JayRflex/6DOF_Robotic_Proyect/Brazo 6GLD - Terrazas, Reynoso.pdf

# Brazo Robot de 6GDL

Francisco Javier Reynoso Concepcion´
8vo semestre
francisco.reynoso@ucb.edu.bo

Jorge Ignacio Terrazas R.
10mo semestre
jorge.terrazas@ucb.edu.bo

Jose Jes ´ us Cabrera Pantoja ´
Docente - Ingeniería Mecatronica ´

Abstract—Este proyecto tiene como objetivo el desarrollo de
un brazo robotico de seis grados de libertad (6GDL) dise ´ | nado ˜
para realizar tareas de manipulacion y estudio en el ´ | ambito ´
de la robotica educativa. El sistema combina el uso de compo- ´ nentes electronicos como servomotores MG996, un controlador ´ PCA9685 y un microcontrolador STM32.
Index Terms—Robotica, Cinem ´ | atica directa, Cinem ´ | atica in- ´
versa, Singularidades, PCA9685, STM32, Servomotores.
I. INTRODUCCION´

La robotica ha evolucionado significativamente desde sus ´ inicios, integrandose de manera profunda en sectores industri- ´
ales, academicos y cotidianos. Los brazos rob ´ | oticos son una ´
de las aplicaciones mas destacadas en este campo, permitiendo ´
la automatizacion de tareas complejas con una alta precisi ´ | on´
y eficiencia [1]. Su desarrollo comenzo con el ”Unimate”, el ´ primer robot industrial, creado en 1961 por George Devol y Joseph Engelberger, que revoluciono la industria manufactur- ´ era [2].
Los brazos roboticos de seis grados de libertad (6GDL) ´ han ganado popularidad debido a su capacidad para moverse en seis ejes independientes, emulando la funcionalidad de un brazo humano. Esta configuracion permite una gran flexibil- ´ idad y versatilidad en aplicaciones como la ensambladura,
soldadura, manipulacion de materiales, cirug ´ | ía robotica y ´
exploracion espacial [3]. Adem ´ | as, se utilizan ampliamente ´
en entornos educativos para la ensenanza de conceptos de ˜
cinematica y din ´ | amica, permitiendo a los estudiantes exper- ´
imentar de manera practica con sistemas avanzados [4]. ´
El diseno y modelado de un brazo rob ˜ | otico requiere una ´
comprension detallada de sus componentes y de las teor ´ | ías
matematicas que lo describen. Las transformadas homog ´ | eneas ´
son fundamentales para modelar la cinematica directa e in- ´
versa, que determinan la posicion y orientaci ´ | on del efector fi- ´
nal [5]. La matriz Jacobiana, por otro lado, es una herramienta crucial para analizar la velocidad de las articulaciones y las singularidades del sistema [6].
En este trabajo, se presenta el diseno, modelado y an ˜ | alisis de ´
un brazo robotico de 6GDL utilizando servomotores MG996 ´ y un controlador PCA9685. Este sistema permite un control preciso de las articulaciones, facilitando su implementacion en ´ aplicaciones experimentales y educativas. Ademas, se estudia ´ el espacio de trabajo del robot, identificando las configu-
raciones optimas para maximizar su desempe ´ | no en tareas ˜
específicas.

II. MARCO TEORICO ´

En esta seccion se abordan los conceptos te ´ | oricos funda- ´
mentales relacionados con los brazos roboticos de seis grados ´ de libertad (6GDL), así como los componentes y metodologías
empleados en su diseno y an ˜ | alisis. ´
A. Grados de Libertad (GDL)
El concepto de grados de libertad se refiere al numero ´ de movimientos independientes que un sistema mecanico ´ puede realizar. En el caso de los brazos roboticos, cada GDL ´ corresponde a un eje o articulacion que permite un movimiento ´ rotacional o traslacional [1]. Los brazos de 6GDL son capaces de manipular objetos en un espacio tridimensional gracias a su capacidad de realizar movimientos complejos.
B. Matrices de Rotacion y Vectores de Posici ´ | on´
Las matrices de rotacion son herramientas matem ´ | aticas ´
utilizadas para describir la orientacion de un sistema en el ´ espacio tridimensional. Cada matriz de rotacion es una matriz ´ ortogonal de 3×3, donde las columnas representan los ejes del sistema de referencia rotado [2]. Los vectores de posicion, por ´ otro lado, especifican la ubicacion de un punto en el espacio ´ en relacion con un sistema de coordenadas. ´

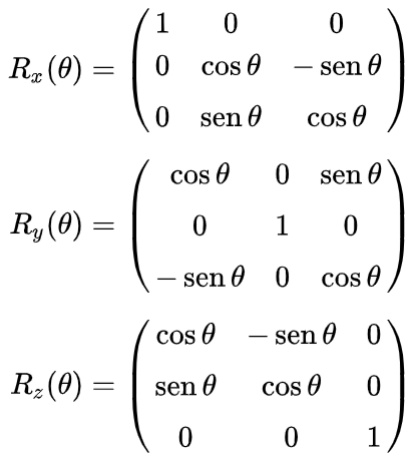
[picture p5: figure]

Fig. 1. Matrices de rotacion. ´

C. Cinematica Directa ´
La cinematica directa se enfoca en determinar la posici ´ | on´
y orientacion del efector final de un brazo rob ´ | otico a partir ´
de los angulos de sus articulaciones. Este proceso se realiza ´

utilizando transformaciones homogeneas, las cuales combinan ´
matrices de rotacion y vectores de traslaci ´ | on para describir la ´
relacion entre los eslabones del robot [3]. ´
D. Jacobianas y Singularidades
La matriz Jacobiana relaciona las velocidades articulares con las velocidades lineales y angulares del efector final. Su analisis permite identificar singularidades, que son configu- ´ raciones en las que el robot pierde grados de libertad o experimenta redundancias cinematicas [4]. Estas singularidades ´
representan limitaciones importantes en el diseno y operaci ˜ | on´
de los robots.
E. Cinematica Inversa ´
La cinematica inversa se ocupa de calcular los ´ | angulos ´
articulares necesarios para que el efector final alcance una
posicion y orientaci ´ | on deseadas. Este problema suele ser m ´ | as´
complejo que la cinematica directa debido a la existencia ´ de multiples soluciones o la imposibilidad de alcanzarlas en ´ ciertos casos [5].
F. Servomotores
Los servomotores son actuadores que combinan un motor
con un sistema de retroalimentacion para controlar su posici ´ | on´
angular. Son esenciales en brazos roboticos debido a su ´ precision y capacidad de respuesta [6]. Los servos MG996R ´ utilizados en este proyecto ofrecen un rango de movimiento de 0° a 180° y son controlados mediante senales PWM. ˜
G. STM32 y PCA9685
El controlador STM32 es un microcontrolador potente y
versatil utilizado en aplicaciones rob ´ | oticas. En este proyecto, ´
se combina con el PCA9685, un controlador PWM de 16 canales, para manejar multiples servomotores de manera efi- ´
ciente [6][7]. Esta configuracion permite una implementaci ´ | on´
robusta y escalable en sistemas roboticos. ´

III. ESPECIFICACIONES DEL PROYECTO
En esta seccion se detallan los requerimientos t ´ | ecnicos y ´
las especificaciones de diseno del brazo rob ˜ | otico, as ´ | í como el
peso estimado de los componentes utilizados.
A. Requerimientos Tecnicos ´
La tabla a continuacion resume los par ´ | ametros clave y ´
requerimientos para el diseno del brazo rob ˜ | otico: ´

TABLE I
REQUERIMIENTOS DEL BRAZO ROBOTICO ´
Parametro ´ | Requerimiento | Unidad
Peso total del brazo | <500 | g
Carga maxima soportada ´ | 100 | g
Alcance maximo ´ | 30 | cm
Velocidad lineal en el extremo | 8 | cm/s
Velocidad angular en el extremo | 0.25 | rad/s
Torque mínimo requerido en los servos | >1 | Nm
Precision angular ´ | ±10 | grados
Voltaje de operacion´ | 5 | V
Temperatura de operacion´ | 10-50 | °C

Estos requerimientos aseguran que el brazo robotico sea ´ funcional, eficiente y adecuado para las tareas propuestas. El torque mínimo y la precision angular se calcularon para ´ garantizar un control adecuado de las articulaciones.

B. Pesos de los Componentes

En la siguiente tabla se detallan los pesos de los compo-
nentes utilizados en el diseno del brazo rob ˜ | otico: ´

TABLE II
PESO DE LOS COMPONENTES
Componente | Cantidad | Peso Total (g)
Eslabon tipo U largo ´ | 4 | 42.08
Eslabon tipo U soporte ´ | 1 | 22.84
Eslabon tipo U soporte cortado ´ | 1 | 14.49
Eslabon tipo soporte servo ´ | 5 | 34.45
Eslabon tipo L soporte ´ | 1 | 3.33
Servomotores MG996R | 6 | 270.00
Total | | 387.19

El peso total del brazo robotico, considerando todos los ´ componentes, es de 387.19 gramos, cumpliendo con el requerimiento de mantener un peso inferior a 500 gramos. Esto permite garantizar la eficiencia mecanica y minimizar la carga ´ sobre los servomotores.

IV. MARCO PRACTICO ´

El marco practico describe las metodolog ´ | | ías empleadas
para analizar y construir un brazo robotico de seis grados de ´ libertad (6GDL). Incluye el desarrollo de las transformaciones
homogeneas, el c ´ | alculo de la matriz Jacobiana, y la evaluaci ´ | on´
del espacio de trabajo. Tambien se detalla la lista de compo- ´ nentes requeridos para la construccion f ´ ísica del robot.

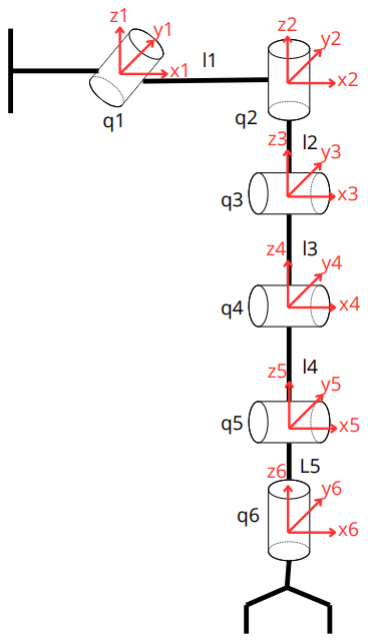
[picture p6: figure]

Fig. 2. Esquematico de brazo robot 6GDL

A. Transformaciones Homogeneas ´
Las transformaciones homogeneas permiten representar la ´
posicion y orientaci ´ | on de los eslabones del robot en el espacio ´
tridimensional. Las matrices obtenidas son las siguientes:

T1 =

cos(q1) | 0 sin(q1) 0
0 | 1 | 0 | 0
− sin(q1) 0 cos(q1) 0
0 | 0 | 0 | 1

,

T2 =

cos(q2) − sin(q2) 0 0
sin(q2) | cos(q2) | 0 0
0 | 0 | 1 0
0 | 0 | 0 1

,

T3 =

1 | 0 | 0 | 0
0 cos(q3) − sin(q3) 0
0 sin(q3) | cos(q3) | 0
0 | 0 | 0 | 1

,

T4 =

1 | 0 | 0 | 0
0 cos(q4) − sin(q4) 0
0 sin(q4) | cos(q4) | l1
0 | 0 | 0 | 1

,

T5 =

1 | 0 | 0 | 0
0 cos(q5) − sin(q5) 0
0 sin(q5) | cos(q5) | l2
0 | 0 | 0 | 1

,

T6 =

cos(q6) − sin(q6) 0 0
sin(q6) | cos(q6) | 0 0
0 | 0 | 1 0
0 | 0 | 0 1

La transformada homogenea final, que describe la posici ´ | | on´
y orientacion del efector final respecto a la base, es el ´ resultado del producto de todas las matrices individuales de transformaciones homogeneas: ´
La transformada global se obtiene multiplicando las matri-
ces homogeneas de cada eslab ´ | on: ´

T

n
0 = T

1/0· T

2/1· ... · T

| n n−1
. | (1)

Esta matriz incluye tanto la orientacion del efector final ´
en terminos de sus vectores de rotaci ´ | on como su posici ´ | on´
en el espacio respecto al origen. Es fundamental para la
determinacion del espacio de trabajo, la cinem ´ | atica directa y ´
la resolucion de la cinem ´ | atica inversa. ´
B. Jacobiana de Posicion´
La matriz Jacobiana relaciona las velocidades articulares con las velocidades lineales del efector final. En este caso, solo se considera la Jacobiana de posicion, la cual se calcula a partir ´ de las derivadas parciales de las transformaciones homogeneas. ´

Jposicion´ =

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
C. Analisis de Singularidades ´

Las singularidades en un brazo robotico ocurren cuando la ´ matriz Jacobiana pierde su rango completo, lo que implica que ciertas posiciones y orientaciones no pueden alcanzarse o que las velocidades articulares tienden a valores infinitos. Para
analizar este fenomeno, se tom ´ | o la submatriz cuadrada de las ´
primeras tres filas y columnas de la Jacobiana de posicion del ´ brazo robotico. ´
La submatriz de la Jacobiana de posicion es: ´

Jsubmatriz =

J11 | J12 | J13
J21 | J22 | J23
J31 | J32 | J33

El determinante de esta submatriz fue calculado como sigue:

det(Jsubmatriz) = −l2 · (l3 sin(q3) + l4 sin(q3 + q4)

+l5 sin(q3 + q4 + q5)) · sin(q2)

La expresion anterior muestra que el determinante depende ´
de los angulos ´ | q2, q3, q4 y q5, así como de las longitudes de
los eslabones l2, l3, l4 y l5. La singularidad ocurre cuando el determinante es igual a cero, es decir:

det(Jsubmatriz) = 0

Interpretacion de Singularidades ´
- Cuando sin(q2) = 0, el sistema entra en una configuracion singular debido a que el brazo pierde un grado de ´ libertad en la direccion transversal. ´
- Si los terminos ´ | sin(q3), sin(q3 + q4), y sin(q3 + q4 + q5)
son simultaneamente cero, la estructura del brazo se ´ alinea, ocasionando una reduccion en el rango de la ´ Jacobiana.
Resultado Experimental
Durante el analisis num ´ | erico y experimental del brazo ´
robotico, se observ ´ | o que el sistema **no se encontraba en una ´
configuracion singular** para las configuraciones evaluadas, ´ como se puede ver en la siguiente salida obtenida:

det(Jsubmatriz) ̸= 0

Esto indica que el brazo mantiene su rango completo y capacidad de movimiento en el espacio de trabajo para las posiciones analizadas.

D. Espacio de Trabajo

El espacio de trabajo del brazo robotico representa todas las ´ posiciones alcanzables por el efector final. En la Figura 3, se muestra el espacio de trabajo calculado mediante simulacion, ´ evaluando todas las combinaciones posibles de los angulos ´ articulares.


Fig. 3. Espacio de trabajo calculado del brazo robotico. ´

TABLE III
LISTA DE COMPONENTES
Componente | Cantidad
Servomotores MG996R | 6
Controlador PCA9685 | 1
Microcontrolador STM32 | 1
Eslabones tipo U | 6
Eslabones tipo L | 2
Tornillería y bases | Variado
E. Lista de Componentes
Para la construccion del brazo rob ´ | otico, se requieren los ´
siguientes componentes:
F. Calculo de Error de Cinem ´ | atica Directa ´

En esta seccion se analiza el error que ocurre al realizar ´
la cinematica directa del brazo rob ´ | otico. Este error es la ´
diferencia entre la posicion objetivo, calculada te ´ | oricamente, ´
y la posicion real alcanzada por el robot. Dicho error se debe ´ principalmente a las propiedades del material utilizado para construir el brazo, el cual esta hecho de PLA, un material ´ plastico que introduce flexiones y deformaciones bajo carga. ´
Ademas, la inercia generada por los movimientos r ´ | apidos ´
tambien afecta negativamente a la precisi ´ | on del sistema. ´
La grafica en la Figura 4 ilustra el error promedio observado ´ en las mediciones realizadas con cada servomotor. Se observa que los servos mas cercanos a la base del robot tienden a ´ tener mayores errores debido al peso acumulado y las fuerzas generadas por los eslabones superiores.
En la Tabla IV, se presentan los valores promedio, mínimos y maximos del error angular para cada uno de los seis ´ servomotores utilizados en el robot. Este resumen permite identificar las limitaciones específicas de cada actuador y su impacto en el desempeno general del sistema. ˜
Estos resultados muestran la importancia de seleccionar materiales y componentes de alta calidad para garantizar la
precision y repetibilidad en aplicaciones rob ´ | oticas. Adicional- ´


Fig. 4. | Error promedio en los servomotores durante la ejecucion de la ´
cinematica directa. ´

TABLE IV
RESUMEN DE ERRORES POR SERVO
Servo | Error Prom. (grados) | Mínimo (grad.) | Maximo (grad.) ´
1 | ±11.0 | 8 | 17
2 | ±12.22 | 3 | 44
3 | ±26.33 | 9 | 66
4 | ±18.56 | 4 | 65
5 | ±12.56 | 6 | 30
6 | ±1.56 | 0 | 10
mente, este analisis permite identificar puntos cr ´ | | íticos en el
diseno del robot que podr ˜ | ían mejorarse en futuras iteraciones.
G. Calculo de Error en Cinem ´ | atica Inversa ´
En esta seccion se presenta el c ´ | alculo del error de posici ´ | on´
generado durante la ejecucion de una secuencia en la que el ´
brazo robotico dibuja un cuadrado en el plano. Este c ´ | alculo ´
permite evaluar la precision del robot en t ´ | erminos de sus ´
capacidades de realizar trayectorias definidas. Los errores observados son atribuibles a factores como la friccion entre ´ las piezas y la inercia de los movimientos, derivados de los materiales utilizados en la fabricacion, principalmente PLA, ´ que afecta la rigidez del sistema.
En la Figura 5, se muestran las desviaciones entre las posiciones objetivo y las posiciones reales alcanzadas por el
extremo del brazo robotico durante la ejecuci ´ | on del cuadrado. ´
El error se distribuye en todos los ejes y se incrementa
significativamente en las esquinas debido a la rapida variaci ´ | on´
de direccion y velocidad en dichas posiciones. ´
La Tabla V muestra un resumen de los errores promedios, mínimos y maximos registrados en cada uno de los servo- ´ motores durante la secuencia. Los datos reflejan que el error promedio varía entre ±3.8 y ±18.88 grados, con el mayor error asociado al servo 0, el cual experimenta las mayores cargas y desplazamientos angulares.
Estos resultados confirman la influencia negativa de las características del material PLA y la dinamica del robot ´ sobre la precision de las trayectorias generadas, sugiriendo ´


Fig. 5. Errores entre posiciones objetivo y reales para una secuencia que forma un cuadrado.

TABLE V
RESUMEN DE ERRORES POR SERVO EN CINEMATICA ´ | INVERSA
Servo | Error Prom. (grados) | Minimo (grados) | Maximo (grados)
0 1 2 3 4 5 | ±18.88 ±7.42 ±8.23 ±4.6 ±5.4 ±3.8 | 7.69 4.7 4.31 4.0 4.0 0.0 | 46.0 13.0 12.31 5.0 6.0 11.0

la necesidad de optimizar los materiales o compensar el error mediante algoritmos de control avanzados.

V. CONCLUSIONES
En este trabajo, se desarrollo y evalu ´ | o un brazo rob ´ | otico ´
de seis grados de libertad (6GDL) disenado para aplicaciones ˜ educativas e industriales de baja complejidad. A continuacion, ´ se destacan las conclusiones principales:
- El robot fue capaz de cumplir con los requisitos establecidos en la tabla de especificaciones. En particular, se comprobo que el brazo puede operar con una carga ´
maxima de hasta ´ | 300 gramos antes de alcanzar el punto
de quiebre estructural, lo cual representa un margen seguro dentro de los límites de diseno. ˜
- El analisis del espacio de trabajo del robot, calculado ´ mediante la transformada homogenea y representado ´
graficamente, demostr ´ | o que el brazo es capaz de alcanzar ´
posiciones complejas dentro de un radio maximo de ´ | 30
cm.
- Los errores observados en las pruebas de cinematica ´ directa e inversa muestran una tendencia creciente a medida que se incrementa la carga y se realiza un
mayor numero de movimientos. El an ´ | alisis experimental ´
identifico errores m ´ | aximos de hasta ´ | 26.33 grados en la
cinematica directa y ´ | 60 grados en la cinematica inversa, ´
principalmente atribuibles a la friccion e inercia derivada ´ del uso de materiales plasticos (PLA) en la estructura. ´
- A nivel de precision angular, el robot alcanz ´ | o un margen ´
de error promedio de ±11.0 grados, lo que, si bien está dentro del requisito inicial de ±10 grados, demuestra que futuras versiones pueden beneficiarse de mejoras en los materiales de construccion y mecanismos de retroal- ´ imentacion. ´
- Los servomotores MG996R utilizados presentaron un torque superior a 1 Nm, cumpliendo con el requisito
mínimo de operacion. Sin embargo, se identific ´ | o que el ´
aumento de la carga al límite estructural afecta negativamente la precision y estabilidad del sistema. ´
- Finalmente, la integracion del microcontrolador STM32 ´
y el controlador PCA9685 permitio una operaci ´ | on sin- ´
cronizada de los servomotores, garantizando la ejecucion´ de las tareas planificadas dentro de los límites de velocidad lineal (8 cm/s) y angular (0.25 rad/s) definidos en los requerimientos.
En conclusion, el brazo rob ´ | otico dise ´ | nado cumple con los ˜
objetivos del proyecto al proporcionar un sistema funcional dentro de las limitaciones estructurales y materiales identificadas. Futuras mejoras en los materiales y mecanismos de control permitiran reducir los errores actuales y aumentar ´ la capacidad de carga del robot, ampliando sus posibles aplicaciones en entornos educativos.

REFERENCIAS

REFERENCES

[1] Concepto.de, ”Robotica – Concepto, historia, tipos, beneficios y carac- ´ terísticas,” [En línea]. Disponible en: https://concepto.de/robotica/.
[2] Robotica10.com, | ”La | Importancia | de | la | Robotica | en ´
el | Mundo | Actual,” | 2024. | [En | línea]. | Disponible | en:
https://robotica10.com/robotica/importancia-de-la-robotica/.
[3] Siciliano, B., Sciavicco, L., Villani, L., & Oriolo, G., ”Robotics: Modelling, Planning and Control,” Springer, 2010.
[4] J. J. Craig, ”Introduction to Robotics: Mechanics and Control,” 4th ed., Pearson, 2016.
[5] J. Angeles, ”Fundamentals of Robotic Mechanical Systems: Theory, Methods, and Algorithms,” 4th ed., Springer, 2014.
[6] Adafruit, ”PCA9685 16-Channel 12-bit PWM Servo Driver,” [En línea]. Disponible en: https://learn.adafruit.com/16-channel-pwm-servo-driver.
[7] STM32, ”STM32 Microcontrollers,” [En línea]. Disponible en: https://www.st.com/en/microcontrollers-microprocessors/stm32-32-bitarm-cortex-mcus.html.
