JayRflex/6DOF_Robotic_Proyect/Eje de coordenadas.png

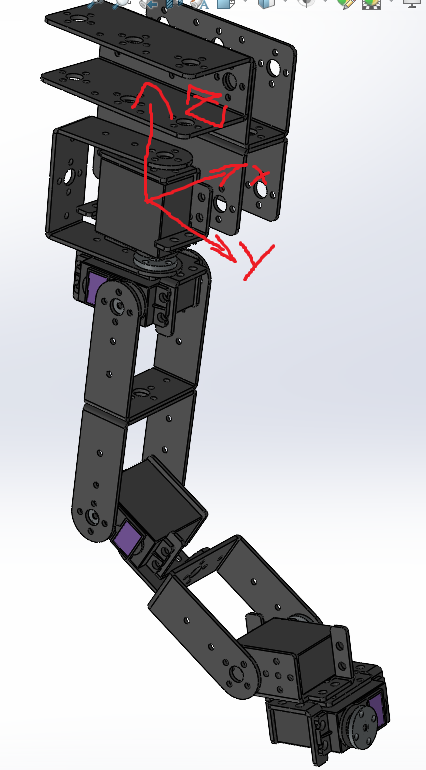
Eje de coordenadas.png
