JayRflex/6DOF_Robotic_Proyect/Planos Robot 6GDL.PDF

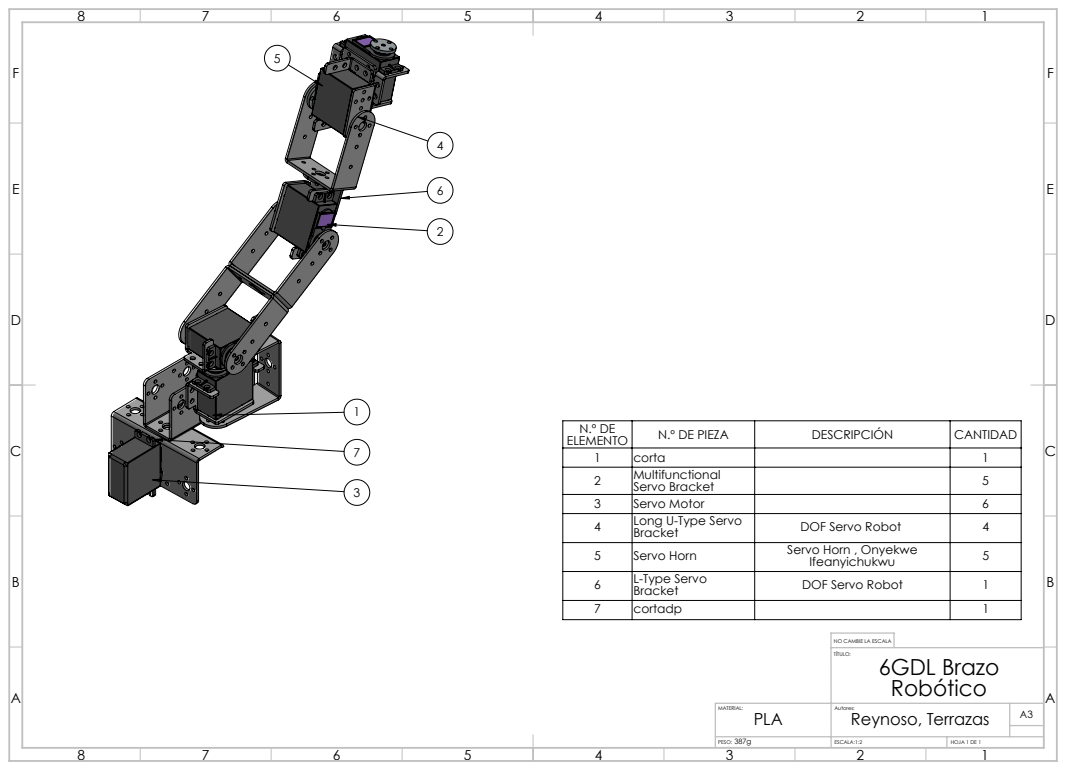
[picture p8: page 1]
ESCALA:1:2; HOJA 1 DE 1

N.º DE ELEMENTO | N.º DE PIEZA | DESCRIPCIÓN | CANTIDAD
1 | corta | | 1
2 | Multifunctional Servo Bracket | | 5
3 | Servo Motor | | 6
4 | Long U-Type Servo Bracket | DOF Servo Robot | 4
5 | Servo Horn | Servo Horn , Onyekwe Ifeanyichukwu | 5
6 | L-Type Servo Bracket | DOF Servo Robot | 1
7 | cortadp | | 1

NO CAMBIE LA ESCALA
TÍTULO:
6GDL Brazo
Robótico
Reynoso, Terrazas

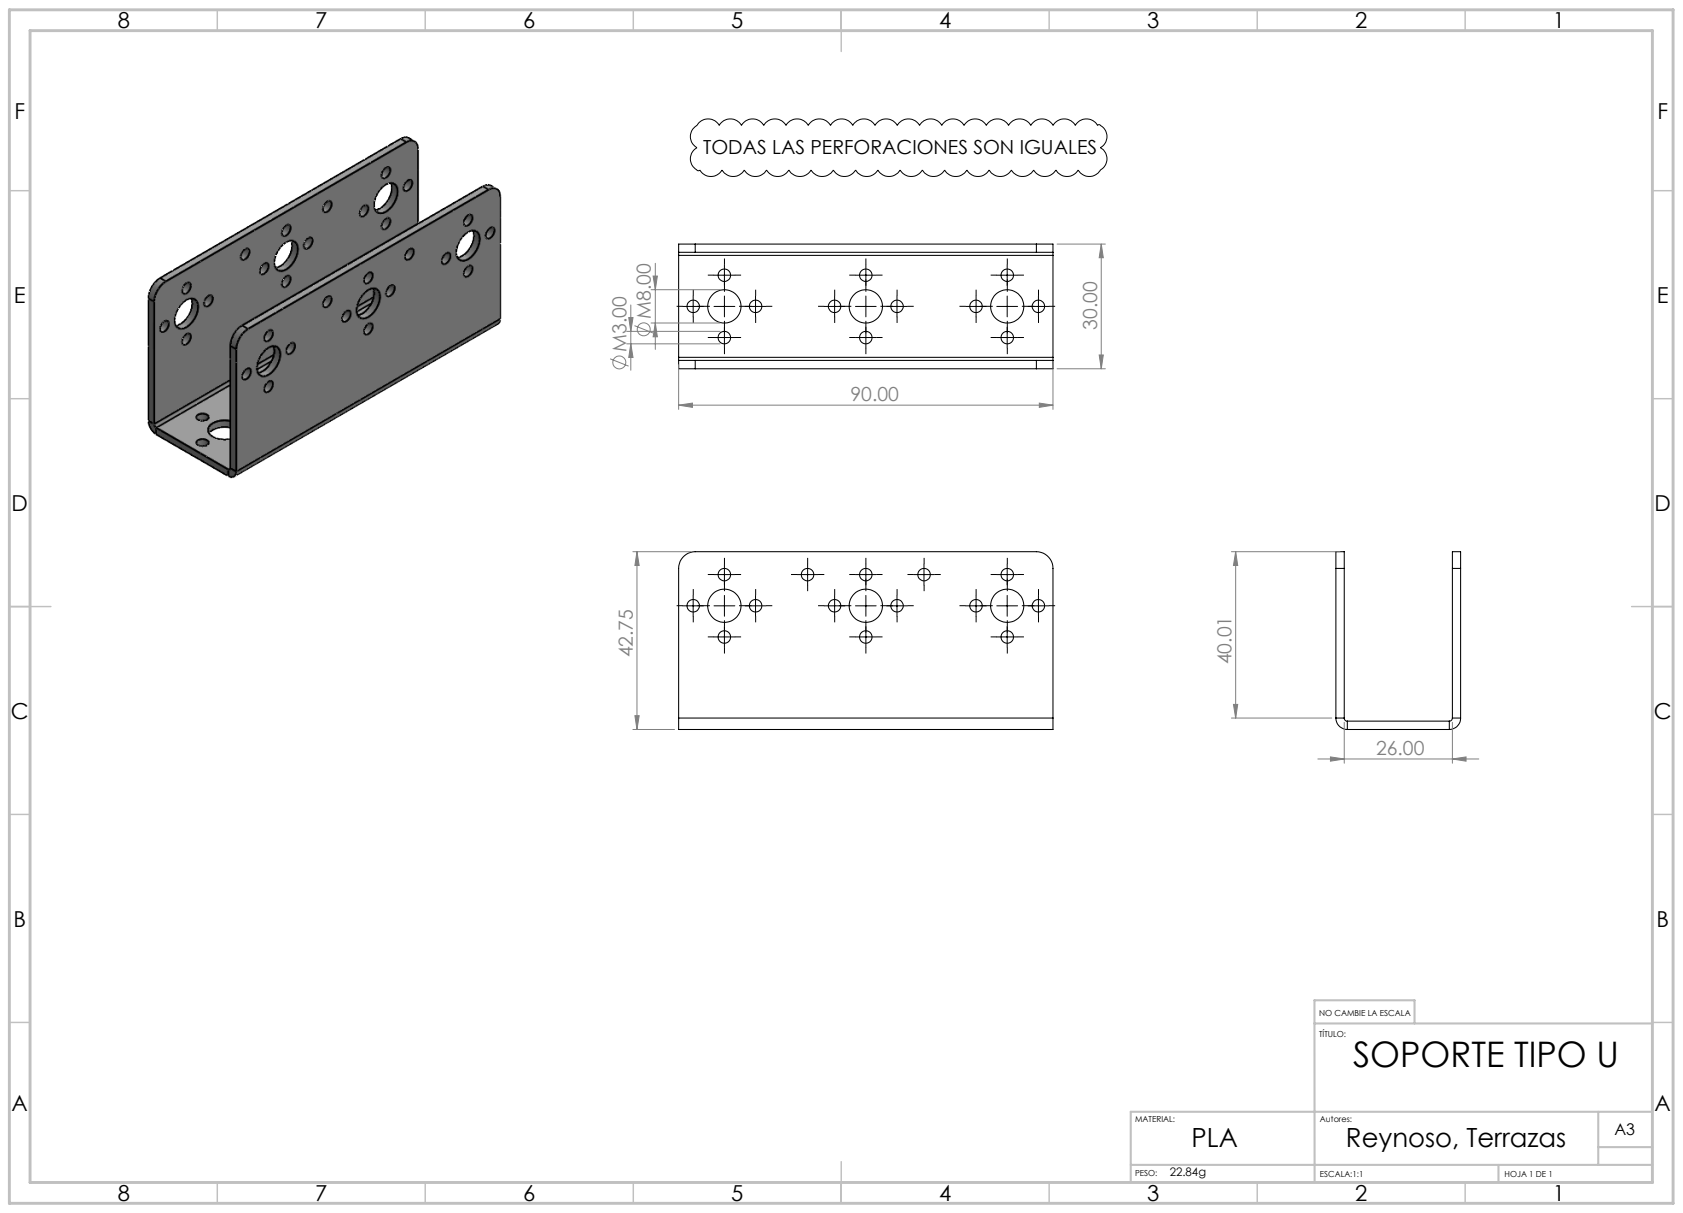
[picture p9: page 2]
ESCALA:1:1; HOJA 1 DE 1

TODAS LAS PERFORACIONES SON IGUALES

NO CAMBIE LA ESCALA
TÍTULO:
SOPORTE TIPO U

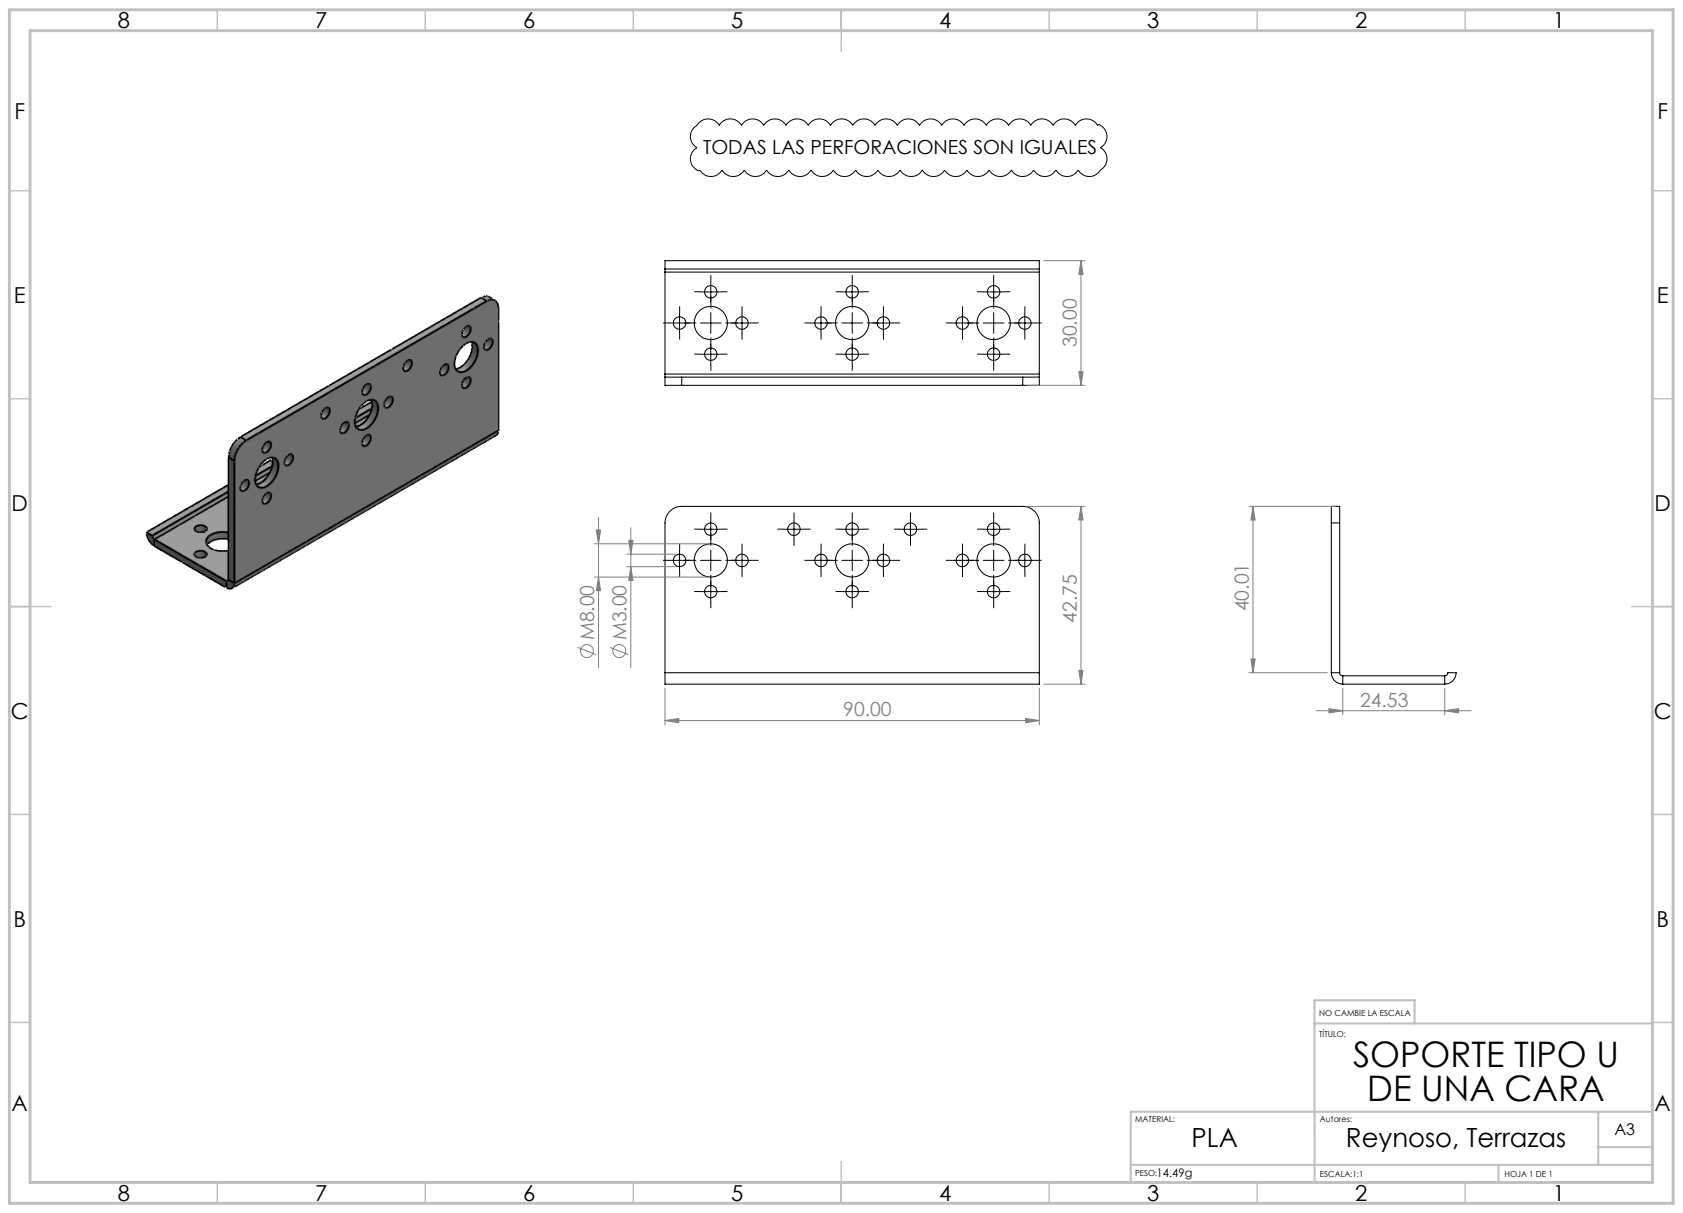
[picture p10: page 3]

TODAS LAS PERFORACIONES SON IGUALES

NO CAMBIE LA ESCALA
TÍTULO:
SOPORTE TIPO U
DE UNA CARA

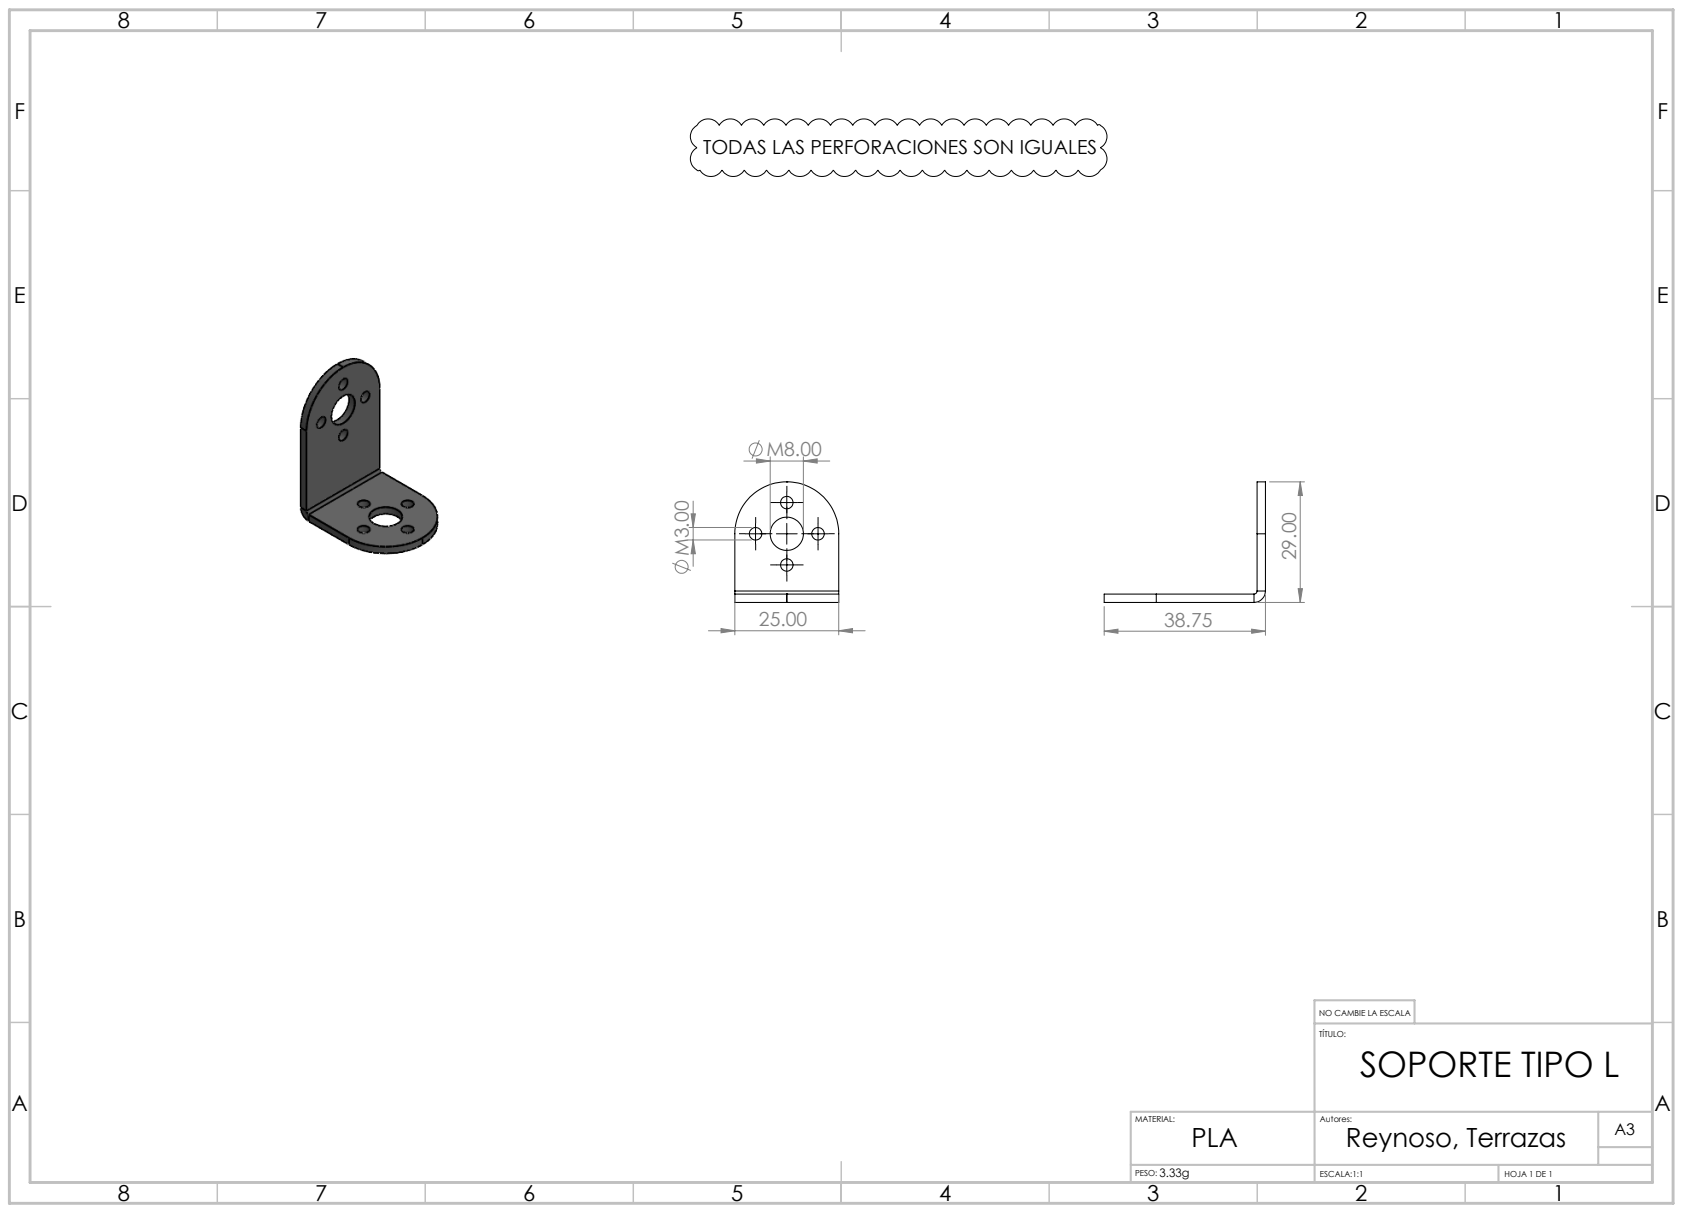
[picture p11: page 4]

TODAS LAS PERFORACIONES SON IGUALES

NO CAMBIE LA ESCALA
TÍTULO:
SOPORTE TIPO L

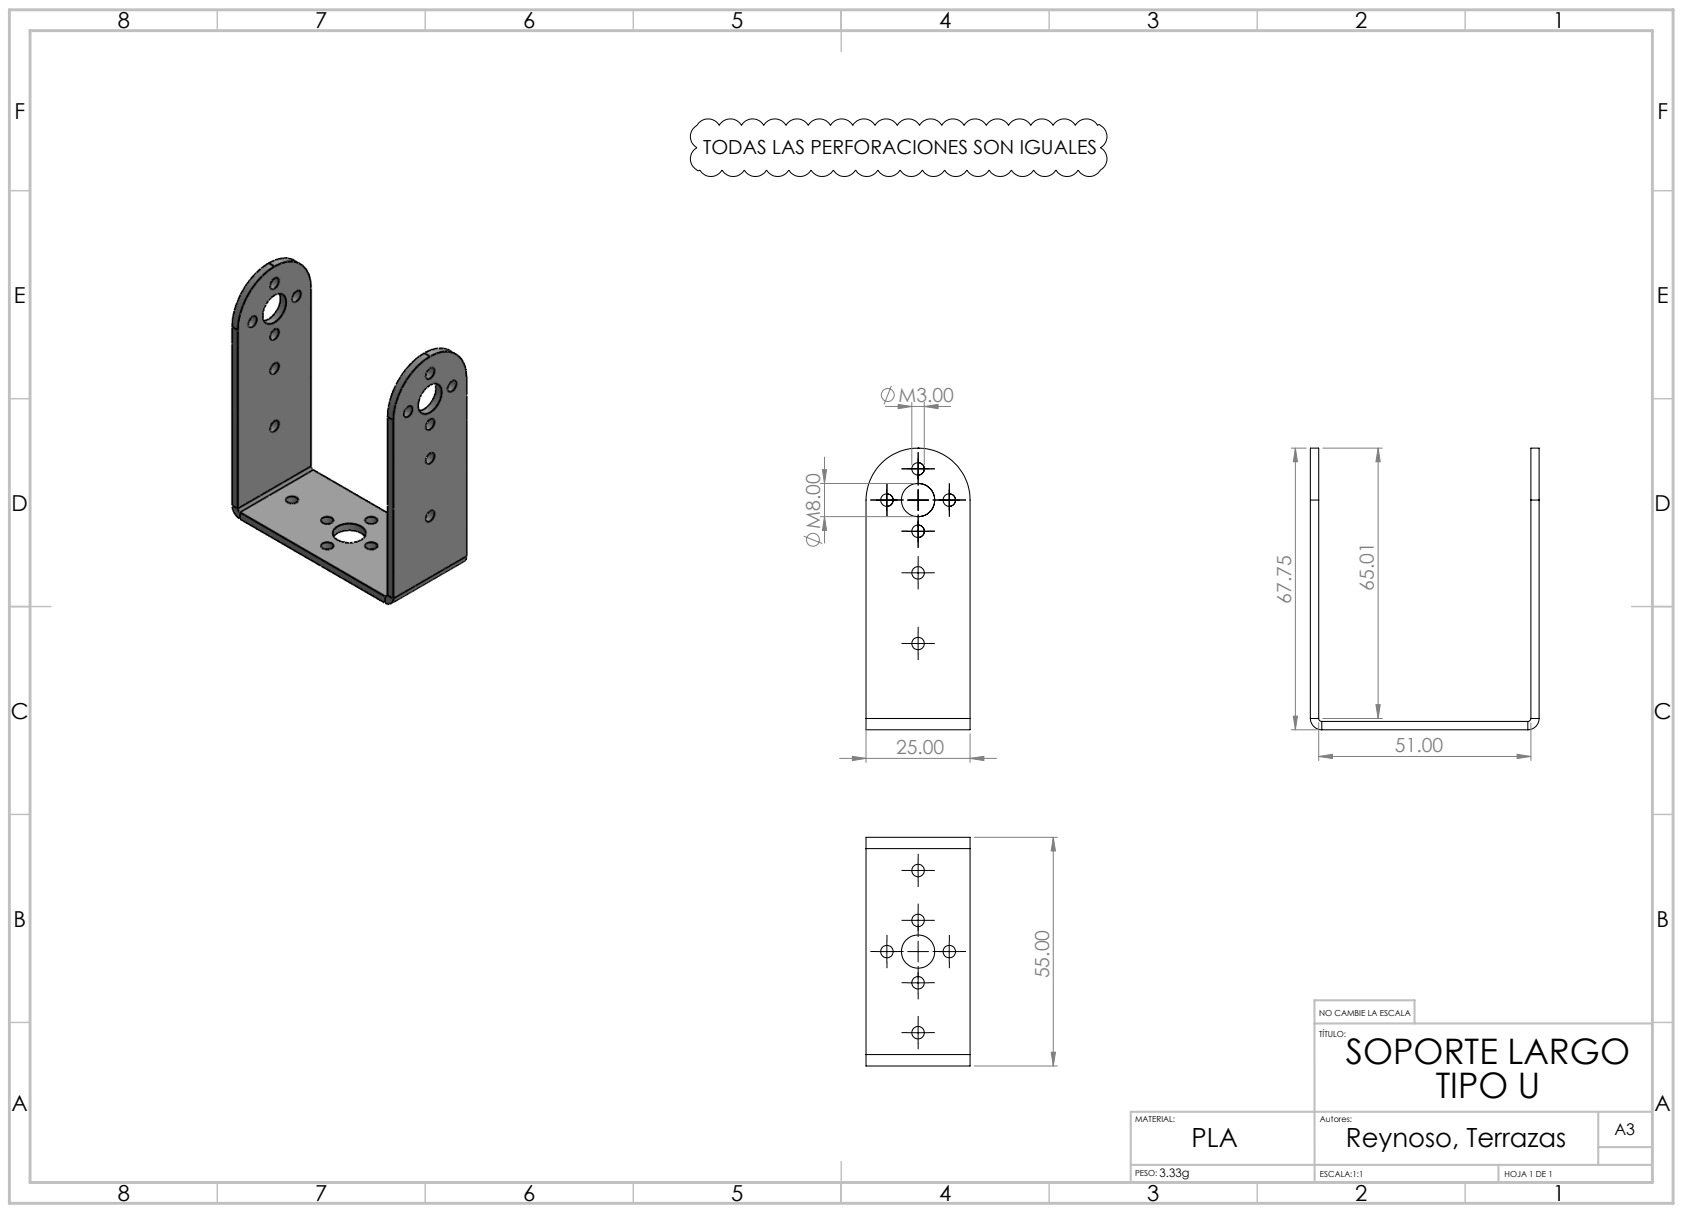
[picture p12: page 5]

TODAS LAS PERFORACIONES SON IGUALES

NO CAMBIE LA ESCALA
SOPORTE LARGO
TÍTULO:
TIPO U

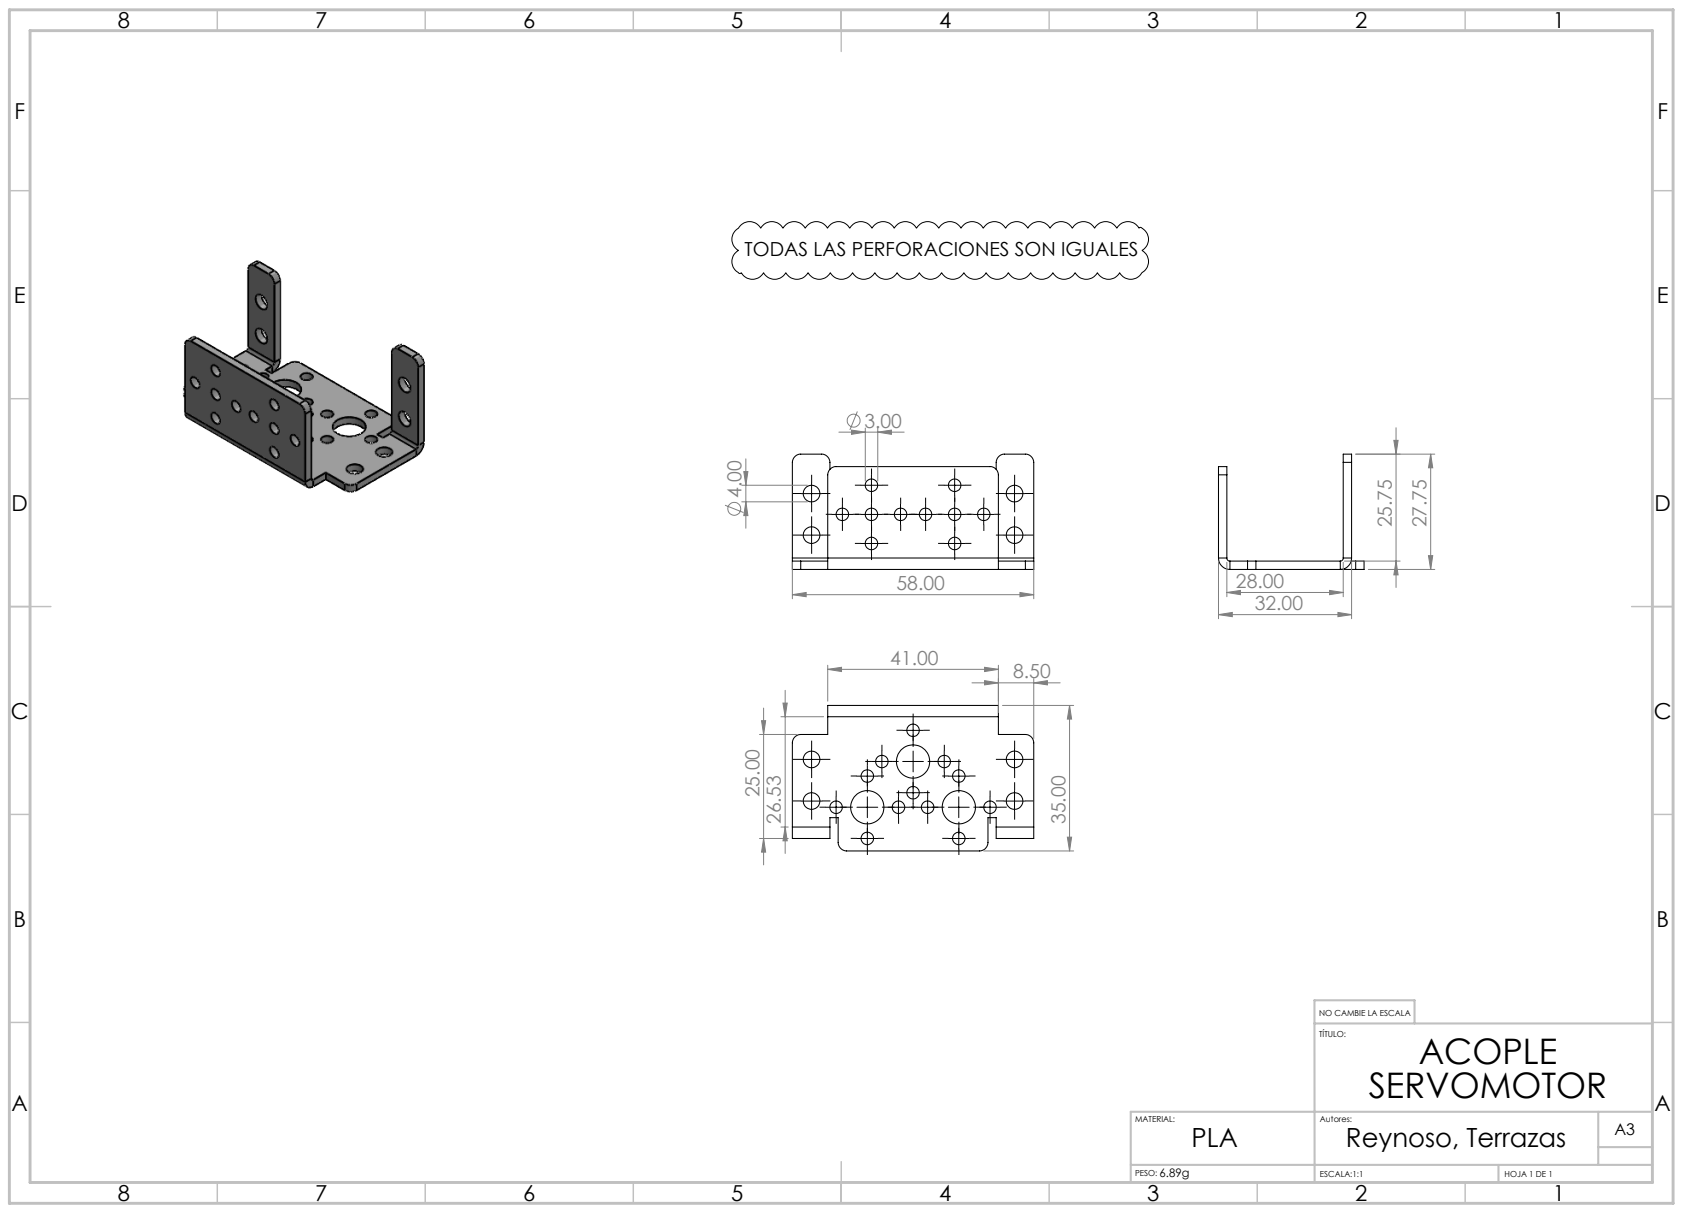
[picture p13: page 6]

TODAS LAS PERFORACIONES SON IGUALES

NO CAMBIE LA ESCALA
ACOPLE
SERVOMOTOR
